Urvin/carFrontWiperRelay/circuit/car_front_wiper_relay.png

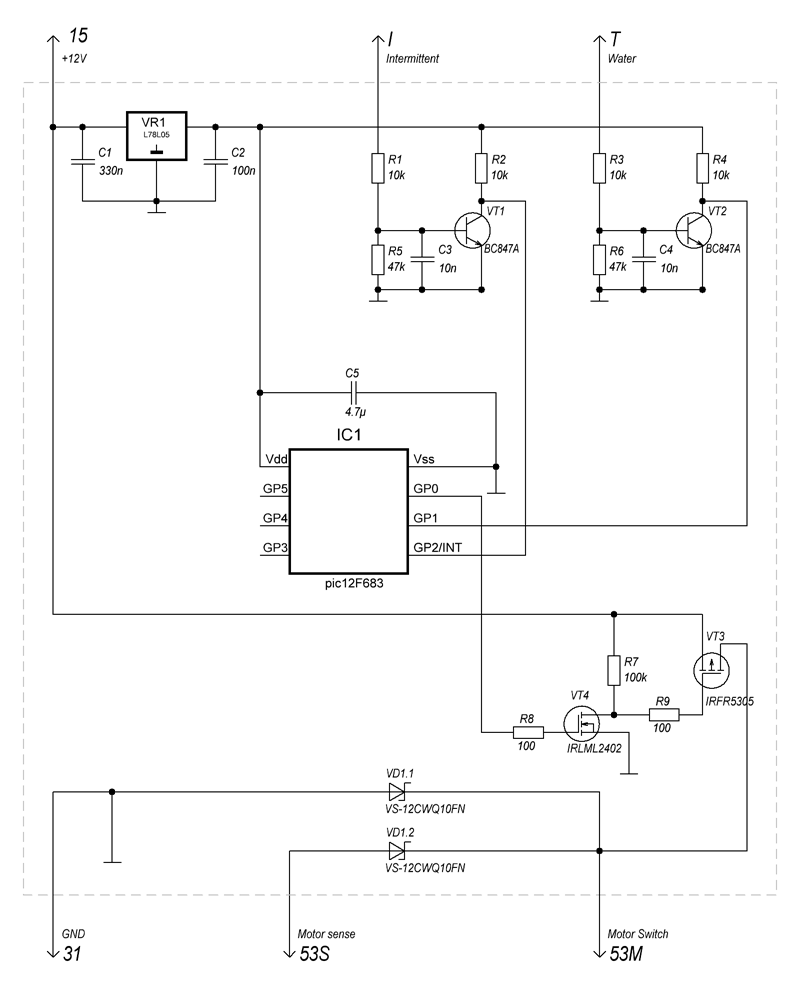
circuit/car_front_wiper_relay.png
