Urvin/carFrontWiperRelay/layout/car_front_wiper_relay.png

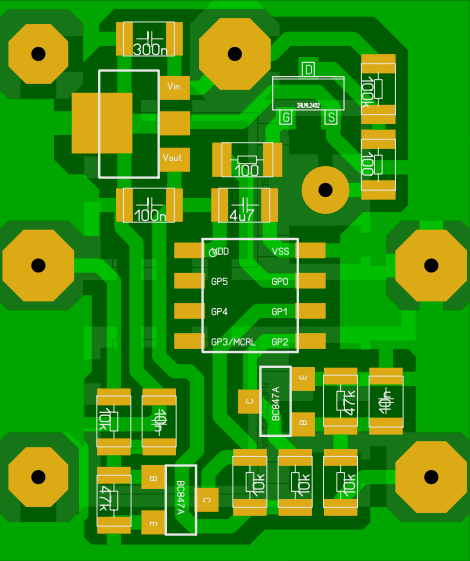
layout/car_front_wiper_relay.png
