Urvin/carFrontWiperRelay/(list of files, drawings)

Other design files:
circuit/car_front_wiper_relay.spl7
layout/car_front_wiper_relay.lay6
model/carFrontWiperRelay.DSN
