Urvin/carFrontWiperRelay/(commit log)

2014-07-17 First circuit sketch
    [car_front_wiper_relay.spl7]
2014-07-21 Sogdiana layout
    [car_front_wiper_relay.lay6]
2014-07-21 Circuit actualization
    [car_front_wiper_relay.lay6, car_front_wiper_relay.spl7]
2014-07-22 Layout errors fix
    [car_front_wiper_relay.lay6]
2014-07-22 Firmware debug Layout size fix MCU model
    [carFrontWiperRelay.DSN, car_front_wiper_relay.lay6]
2014-07-24 'Hardware PWM' comment removed =)
2014-07-26 Water start in water removement mode fix code beautification
    [carFrontWiperRelay.c]
2014-07-26 Water removement on intermittent mode on fix
    [carFrontWiperRelay.c]
